SethMWard/ECE-411-Practicum/Group Documents/EagleFiles/Read_Me.txt

T-11 SPTA_V7 Update
Date 11/9/14
Time: 22:44

.SCH
	1) Moved R5.
	4) Changed info box colore.
.LBR
	1) moved power traces.
	2) Increaced power trace width.
