SethMWard/ECE-411-Practicum/Weekly-Status-Reports/Lorenzen-Week#11.md

#Weekly Progress Report
Lorenzen Devin <br>
Week ending: 11-14-2014 <br>

##Last week
----------
  1. creaded Excell BOM
  2. descussed Presintation with group
  3. Presented Project
