SethMWard/ECE-411-Practicum/Weekly-Status-Reports/Lorenzen-Week#10.md

#Weekly Progress Report
Lorenzen Devin <br>
Week ending: 11-7-2014 <br>

##Last week
----------
  1. updated BOM
  2. Updated Packaging
  started Presintation
  
##Tasks for next weak
---------
  1. finish presintation
  2. finish package assembaly
  3. Make a Excell BOM
