SethMWard/ECE-411-Practicum/Weekly-Status-Reports/Lorenzen-Week#8.md

#Weekly Progress Report
Lorenzen Devin <br>
Week ending: 11-23-2014 <br>

##Last week
----------
  1. Meet with group to test SPTA board.
  2. update LED brakout board.
  3. Fab LED brakout board.
  
##Tasks for next weak
---------
  1. assemble final project.
  2. continue testing.
  3. update BOM pricing.
