SethMWard/ECE-411-Practicum/Weekly-Status-Reports/Lorenzen-Week#9.md

#Weekly Progress Report
Lorenzen Devin <br>
Week ending: 11-30-2014 <br>

##Last week
----------
  1. continued testing
  2. updating BOM
  
##Tasks for next weak
---------
 1. finish updating BOM pricing.
 2. finish testing.
 3. work on presintation/demo.
