SethMWard/ECE-411-Practicum/Weekly-Status-Reports/Week7Seth.md

Last Week

Trained on EPL soldering stations

Trained on EPL reflow oven

Next Week

assemble boards
Test and debug assembled board
