SethMWard/ECE-411-Practicum/Weekly-Status-Reports/Week8Seth.md

Last Week:

* Assembled boards
* Tested assembled board
* Updated document links on github wiki

Next Week:

* Design Product case
* Train on laser cutter in the EPL
