SethMWard/ECE-411-Practicum/Weekly-Status-Reports/Week7Jeremiah.md

Last Week
---------------
	Created/Review test plan
	Recreate LED breakout board
	Solder LED breakout board
	
Next Week
---------------
	Meet with group to go over test plan
	Start unit testing board as it goes together
	Assemble final board
	Assemble LED breakout
