SethMWard/ECE-411-Practicum/Weekly-Status-Reports/Week8Jeremiah.md

Last Week
---------------
	Unit testing components - All units passed except for antenna (was able to measure up to 512MHz).
	Soldering for LED breakout board and assembled breakout board.
	EPL training on solder stations, solder template, board creation.
	Cut solder template.
	Cut new LED board.
	
Next Week
---------------
	Put together final boards
	Finish testing of antenna
	Put together cut box for boards
