SethMWard/ECE-411-Practicum/Weekly-Status-Reports/Week9Jeremiah.md

Last Week
---------------
	Unit testing component antenna and components again.
	Soldering for LED breakout board and assembled breakout board.
	EPL training on reflow oven.
	Cut solder template.
	Assemble SPTA board.
	Started looking at box for board - Seth will finish.
	
Next Week
---------------
	Put together final boards
	Finish testing of antenna
	Put together cut box for boards
	Presentation
	Test all boards
	Update all documents
	
Issues
---------------
	Need to find vibration sensor for board
