SethMWard/ECE-411-Practicum/Weekly-Status-Reports/Week9Edward.md

Last Week
---------
      Constructed complete board, excluded buzzer resistor for testing purposes
      Revised code to add RF functionality, all functionality now working
      
Next Week
---------
      Presentation
      Test buzzer with different resistors to try to increase volume
