SethMWard/ECE-411-Practicum/Weekly-Status-Reports/Week8Edward.md

This Week
---------
      Initial testing of board
      Construction of LED board

Next Week
---------
      Write and test code
      Board testing
