SethMWard/ECE-411-Practicum/Weekly-Status-Reports/Lorenzen-Week#6.md

#Weekly Progress Report
Lorenzen Devin <br>
Week ending: 11-16-2014 <br>

##Last week
----------
  1.	Meet with group and discussed project block diagram.
  2.	Updated LED breakout board layout.
  3.		Print LED breakout board.
  4.	Cut solder templet.
  
##Tasks for next weak
---------
  1.	Meet with group discuss testing plan.
  2.	Create test plat.
  3. Solder LED breakout board.
  4. Solder for SPTA board.
