SethMWard/ECE-411-Practicum/Weekly-Status-Reports/Lorenzen-week#7.md

#Weekly Progress Report
Lorenzen Devin <br>
Week ending: 11-16-2014 <br>

##Last week
----------
  1. Meet with group discuss testing plan.
  2. Solder LED breakout board.
  3. Solder for SPTA board.

##Tasks for next weak
---------
  1.	Meet with group to test SPTA board.
  2. update LED brakout board.
  3. cut project packaging.
  4. assemble final project.
  5. start project demo.
