SethMWard/ECE-411-Practicum/Weekly-Status-Reports/Week5Edward.md

Previous Week
-------------
      Assisted with board layout
      Assisted with schematic revisions 
      Wrote first draft and assisted with revision of project schedule
      Met with team to discuss project

Next Week
---------
      Check on parts
      Discuss case
      Start construction if boards recieved early
      EPL training
