SethMWard/ECE-411-Practicum/Weekly-Status-Reports/Week5Seth.md

Last Week

Reviewed microprocessor schematics
Updated parts lists to prep for order
Reviewed schematics as a group and prepared to submit preliminary layout 
with no DRC errors

Next Week

Add BOM wiki page
Request RBP-440+ samples
Train on PCB router/plotter
Update wiki
Work on System Modeling and Design of project
