SethMWard/ECE-411-Practicum/Weekly-Status-Reports/Week6Edward.md

This week
---------
      Contributed to system Modeling / UML State Machine View
      EPL Training for board router

Next week
---------
      Board assembly
      More EPL training
