SethMWard/ECE-411-Practicum/Weekly-Status-Reports/Week6Seth.md

Last Week

Added BOM wiki page
Requested RBP-440+ samples
Trained on PCB router/plotter
Updated wiki homepage
Worked on System Modeling and Design of project

Next Week

Train on EPL soldering stations
Train on EPL reflow oven
assemble boards
Test and debug assembled board
