SethMWard/ECE-411-Practicum/Weekly-Status-Reports/Lorenzen-Week#4.md

#Weekly Progress Report
Lorenzen Devin <br>
Week ending: 11-02-2014 <br>

##Last week
----------
	1.	Meat with group and discussed project needs, task updates, areas of concern.
	2.	Refined schematic layout with Mr. Sayers.
	3.	Updated library files.
	4.	Added SMT-440+ band pass filter to eagle library.
 5.~~Find SMA connector~~(Mr. Ward) <br>
##Tasks for next weak
---------
	1.	Review/update board layout.
	2.	Finalize all library files.
	3.	Confirm part package numbers.
	4.	Release board design for ordering.
