SethMWard/ECE-411-Practicum/Weekly-Status-Reports/Week4Jeremiah.md

Last Week
---------------
	Met with group to review project schematics
  Created schematics for breakout board that includes LEDs and push button switch
  Installed AVR Studio to begin building interrupt handling code for microprocessor
	Trained on EagleCad for schematics and library creation
	
Next Week
---------------
	Meet with group to continue refining schematic
	Create more libraries for LEDs 
  Create schematic for housing unit for the final board
	Take EPL training
	Continue learning to code interrupts for Atmel microprocessor
  Take on the role as Test Planner
	
Issues
---------
	Waiting on parts from Digikey
  Need to meet with Cody/Andrew to better understand the Test Plan
