SethMWard/ECE-411-Practicum/Weekly-Status-Reports/Week4Seth.md

Last Week

Met with group to discuss project schematics
Reviewed data sheets for microprocessor
Updated wiki parts page
Created github directory to contain datasheets
Uploaded datasheets to github
Began assembling needed parts list

Next Week

Determine minimum manufacturing cost
Updated wiki home page
Review microprocessor schematics
Update parts lists to prep for order
Continue compiling  per-unit product cost analysis
Review schematics as a group and prepare to submit preliminary layout 
with no DRC errors
