SethMWard/ECE-411-Practicum/Weekly-Status-Reports/Week3Seth.md

Last Week
-----------------------------------------------------------
1. Met with group to determine project direction
2. Met with group to determine project requirements
3. Met with group to determine project schematics
4. Reviewed data sheets for microprocessor, and RF sensor
5. Updated wiki home page
6. Updated wiki parts list
7. Installed EagleCad
8. Revised Product design specification
	
Next Week
-----------------------------------------------------------
1. Design schematics breakout board for LT5538
2. Update Wiki
	a. Assemble all datasheets into one location
	b. Create page for Product design specification
3. Review microprocessor schematics
4. Start on per-unit product cost analysis
