SethMWard/ECE-411-Practicum/Weekly-Status-Reports/Lorenzen-week#3.md

#Weekly Progress Report
Lorenzen Devin <br>
Week ending 10-26-2014 <br>

##Last week
----------
	1.	Meat with group and discussed requirements, code operation, component selection.
	2.	Develop first draft Project Requirements Document (100%)
	3.	Develop a full schematic (100%)
	4.	Add needed components to eagle cad library (90%)
		a.	Need to find a .25 inch SMA mail connector 
##Tasks for next weak
---------
	1.	Find a .25 inch SMA mail connector
	2.	Finish adding components to eagle’s library
	3.	Develop PCB layout
