SethMWard/ECE-411-Practicum/Weekly-Status-Reports/Week3Edward.md

Last Week
---------
      Met with group to discuss project
      Created a prototype board to simulate stimulus to the ATMEGA328
      Created program for ATMEGA328 and tested it using stimulus from prototype board

Next Week
---------
      Continue refining and testing program
      Training on EPL equipment
