SethMWard/ECE-411-Practicum/Weekly-Status-Reports/Week3Jeremiah.md

Last Week
---------
	Met with group to determine project direction
	Met with group to determine project requirements
	Met with group to determine project schematics
	Reviewed data sheets for microprocessor, and RF sensor
	Ordered SMT packages for microprocessor, voltage regulators
	Ordered dragon board for home testing of microprocessor
	Installed EagleCad
	
Next Week
---------
	Meet with group to continue refining schematic
	Prototype board with RF Chip, voltage regulator, microprocessor and 9v battery
	Take EPL training
	Start coding for interrupt handling and output states
	
Issues
------
	EPL lab being moved soon
	AVR are currently down to one
