SethMWard/ECE-411-Practicum/Group Documents/ECE411 Team 11 Suspicious Package Training Aid.pptx

## Team 11 Suspicious Package Training Aid

Jeremiah Franke
Devin Lorenzen
Edward Sayers
Seth Ward

## Problem Overview

- A request for a training aid from the Oregon Zoo.
- Specific protocols need to be followed in the event of the discovery of an unattended package.
- The unattended package needs to be isolated and unmoved.
- Radio communication cannot be used in proximity of the device.

## Marketing Requirements

Must:
- Be able to detect when a two-way radio is transmitting at a frequency of 410-470 MHz in proximity of the device.
- Be able to detect if the device is moved or agitated.
- Be able to notify the end user if either of the previous two events has occurred.
- Be portable and easily concealed.
- Last the duration of a training period.
Should:
- Notify the user of which event specifically caused a training fault.
May:
- Wireless activation of the device.
- Allow users to modify sensitivity of RF detection.

## Current Market Solutions

- There are several available alternatives on the market
  - These solutions are prohibitively expensive and single purposed
  - None of the solutions offered met the marketing requirements in a single device.

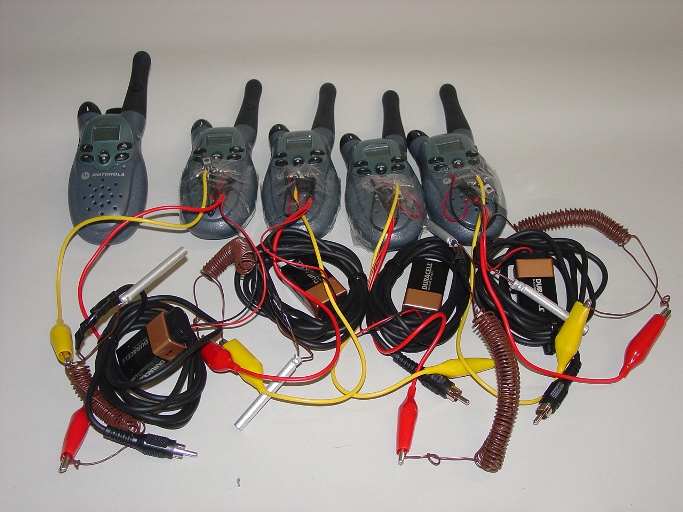
[picture p1: figure]
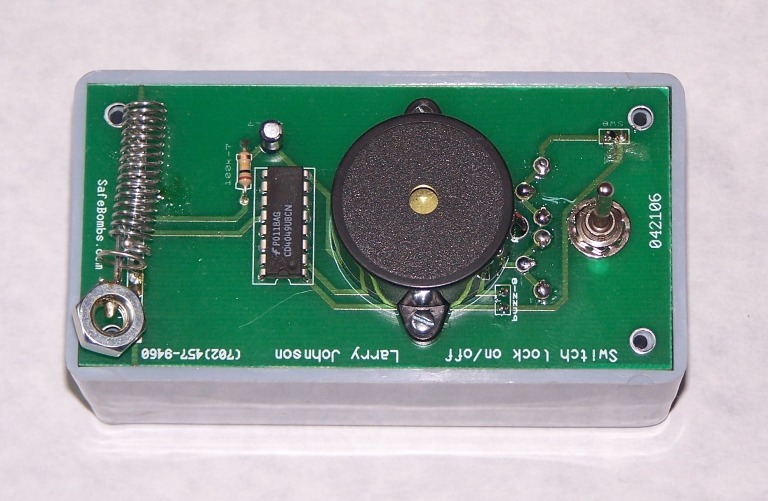
[picture p2: figure]

## Project Implementation

- Vibration sensor
- RF detector
- Auditory and visual indicators
- Microcontroller

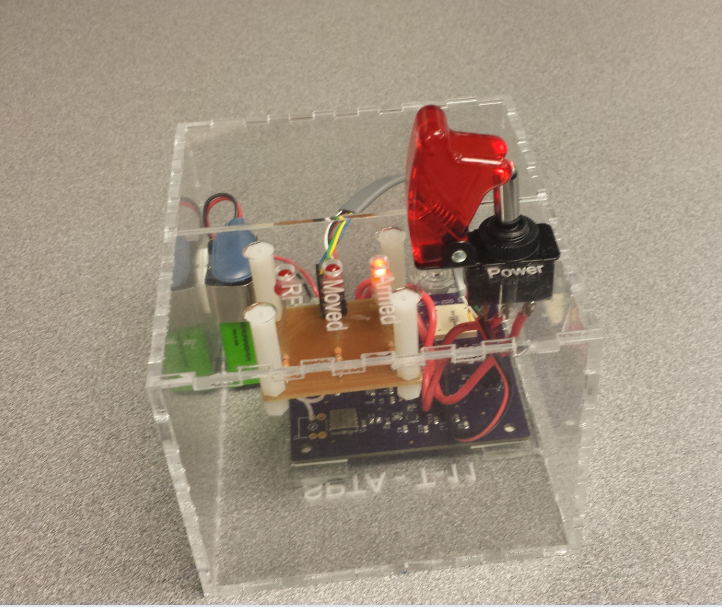
[picture p3: figure]

## Level 1 Block Diagram

## Schematics

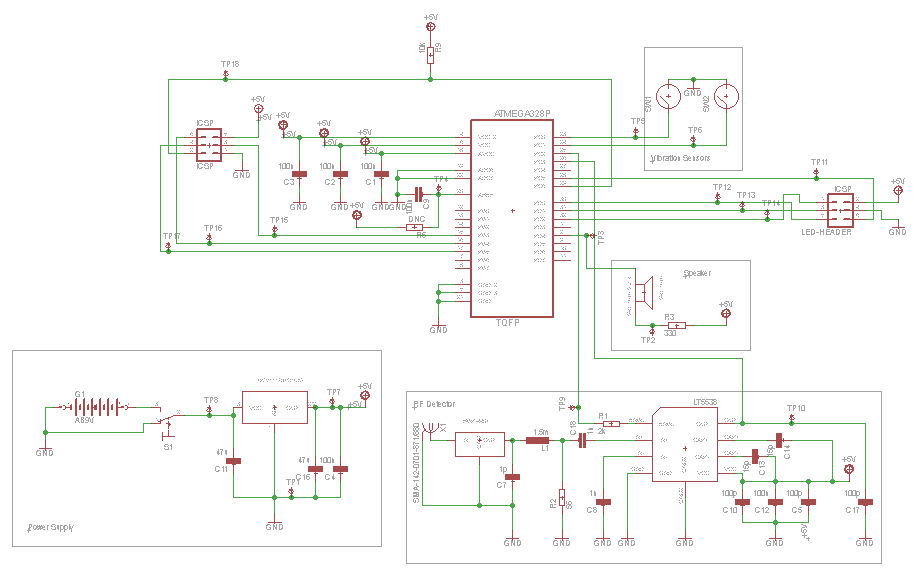
[picture p4: figure]
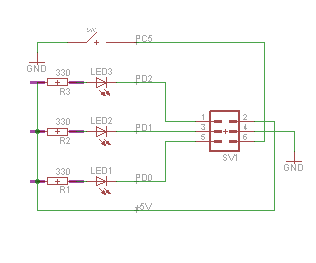
[picture p5: figure]

## Board Layout

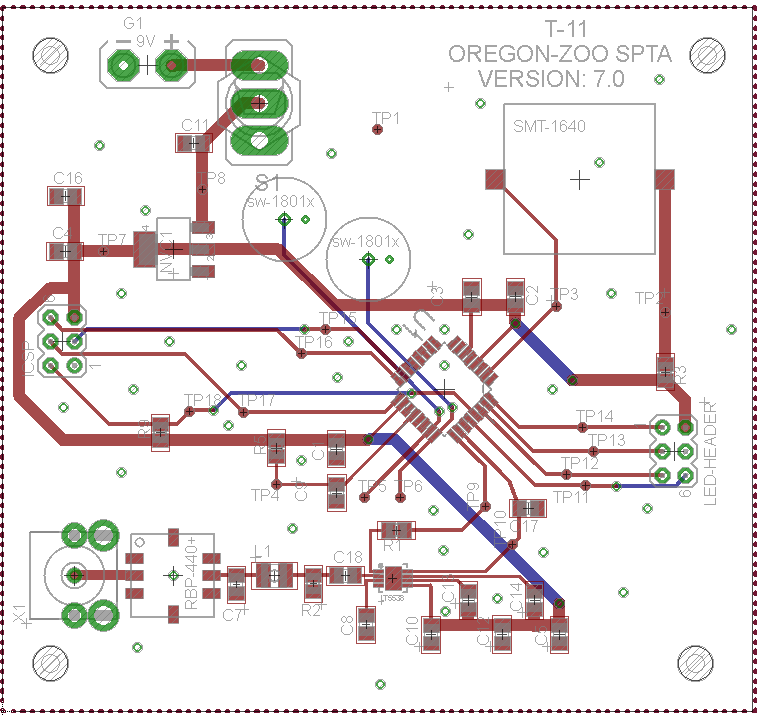
[picture p6: figure]
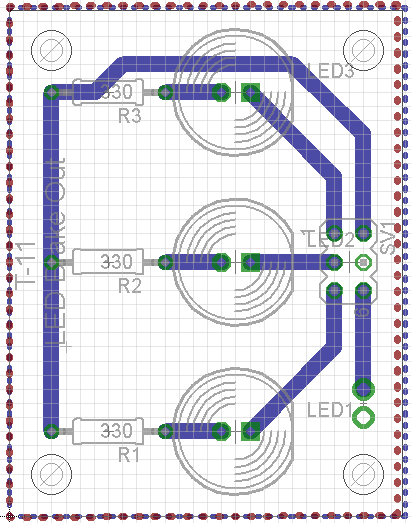
[picture p7: figure]

## Source Code Overview

## Tools Used

- Hardware

- LPKF Board Router
- Reflow Oven
- Laser Cutter
- Soldering Iron
- AVR Dragon

- Software

- Atmel Studio 5
- Eagle Cad
- InkScape

## Testing

- Power Regulation
- RF Detection
- Movement Detection
- LED Indicators
- Power Switch
- Processor
- Buzzer

## Statistics

- 68% surface mount components
- Current draw while armed: 56.5 mA
- Current draw while triggered: 37 mA
- Estimated battery life of 10 hours
- 175 lines of code

## Slide 13

Contributions

Task | Primary contributors
Board Schematic | Devin, Edward
Board Layout | Devin
Code | Edward
Part Acquisition | Jeremiah, Seth
GitHub and Wiki Management | Seth
Documentation | All
Assembly | All
Testing | Jeremiah, Edward

## What we would do differently

Results

- All four boards were fully assembled and function tested
- RF section performed as expected
- Vibration section worked adequately

- Explore other options for the vibration sensor
- Source a louder buzzer
- Remote activation switch
- Opaque and water resistant packaging
- Onboard RF sensitivity calibration
- Source or design a less expensive band pass filter

## Lessons Learned

- How to use the tools in the EPL lab
- Group Project Design
- Teamwork
- Compromise
- Eagle Cad
- Revision Control
