SethMWard/ECE-411-Practicum/Group Documents/Images/Main Schematic.png

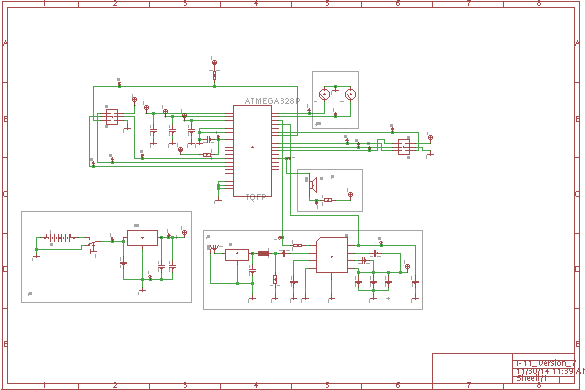
Group Documents/Images/Main Schematic.png
