SethMWard/ECE-411-Practicum/Group Documents/SPTA BOM.xlsx

SPTA Board
QTY | Value | Package | Part | Description | Manufacturer | Model# | Unit Price (US $) | Total (US $) | 1,000 Unit Price (US$)
1 | NA | 320-916 | S1 | Toggle switch | Radio Shack | 275-601 | 5.49 | 5.49 | 5.49
1 | 1.5n | L2825P | L1 | Inductor | Panasonic | ELJ-QF1N5DF | 0.26 | 0.26 | 0.1705
6 | 100n | 0805 | C1, C2, C3, C4, C9, C12 | Capacitor | Kemet | C0805C104k5RACTU | 0.1 | 0.6 | 0.012
3 | 100p | 0805 | C5, C10, C17 | Capacitor | Kemet | C0805C101J5GACTU | 0.1 | 0.3 | 0.0114
1 | 10K | 0805 | R9 | Resistor | Stackpole electronics | RMCF0805FT10K0 | 0.1 | 0.1 | 0.00448
2 | 15p | 0805 | C13, C14 | Capacitor | Samsung | CL21C150JBANNNC | 0.1 | 0.2 | 0.0159
2 | 1n | 0805 | C8, C18 | Capacitor | Kemet | C0805C104K5RACTU | 0.1 | 0.2 | 0.012
1 | 1p | 0805 | C7 | Capacitor | Samsung | CL21C010BBANNNC | 0.1 | 0.1 | 0.00588
1 | 20k | 0805 | R5 | Resistor | Panasonic | ERJ-6ENF2002V | 0.1 | 0.1 | 0.008
1 | 2k | 0805 | R1 | Resistor | Panasonic | ERJ-6ENF2001V | 0.1 | 0.1 | 0.008
1 | 330 | 0805 | R3 | Resistor | Stackpole electronics | RMCF0805JT330R | 0.1 | 0.1 | 0.00448
2 | 47u | 0805 | C11, C16 | Capacitor | TDK | C2012X5R1A476M125AC | 1.03 | 2.06 | 0.369
1 | 56 | 0805 | R2 | Resistor | Stackpole electronics | RMCF0805JT56R0 | 0.1 | 0.1 | 0.0032
1 | NA | AB9V | G1 | Battery Clip | Keystone | 71 | 0.42 | 0.42 | 0.18209
1 | NA | TQFP-32 | U1 | 8-bit Micro Controller | Atmel | ATMEGA328-AUR | 3.51 | 3.51 | 1.75401
2 | NA | MA03-2 | led-Header, SV1 | Pin Header | TE Connectivity | 5-5176264-8 | 0.4 | 0.8 | 0.1893
1 | NA | DFN-DD | LT5538 | RF Power Detector | Linear Technology | LT5538IDD#PBF | 6.4 | 6.4 | 4.5
1 | NA | SOT223 | NVC1 | LDO Voltage Regulator | ON Semiconductor | NCV1117ST50T3G | 0.99 | 0.99 | 0.39848
1 | NA | GP731 | RBP-440+ | Band Pass Filter | Mini Curcuits | RBP-440+ | 15.95 | 15.95 | 13
1 | NA | SMT-1640 | SMT-1640 | Piezo Buzzer | PUI Audio | SMT-1640-S-2-R | 2.5 | 2.5 | 1.3195
1 | NA | SW-1801X | SW1, SW2 | Vibration Sensor | Adafruit | SW18010P | 0.95 | 0.95 | 0.76
1 | NA | NA | NA | Device Package | T-11 | SPTA-PackageV2 | 8 | 8 | 8
1 | NA | NA | SPTA -Board | mother board | T-11 | SPTA-V7 | 15.33 | 15.33 | 11.5
 |  |  |  |  |  |  | Sub Total | 64.56
LED Brake Out Board
QTY | Value | Package | Part | Description | Manufacturer | Model# | Unit Price (US $) | Total (US $) | 1,000 Unit Price (US$)
3 | NA | 10mm | LED1, LED2, LED3 | LED | CREE | C5SMF-RJS-CT0W0BB2 | 0.21 | 0.63 | 0.136
3 | 330 | 0207/10 | R1, R2, R3 | Resistor | Stackpole electronics | CF14JT330R | 0.1 | 0.3 | 0.008
1 | NA | MA03-2 | Led-Header | Pin Header | TE Connectivity | 5-5176264-8 | 0.4 | 0.4 | 0.1893
1 | NA | LEDBOB | Board | LED Breakout Board | T-11 | LEDBOB-V8 | 5 | 5 | 30
 |  |  |  |  |  |  | Sub Total | 6.33
 |  |  |  |  |  |  | Total | 70.89
