SethMWard/ECE-411-Practicum/Group Documents/Integration test RF&CPU.docx

Test Writer: Jeremiah Franke
Test Case Name: | | | | | RF CPU Integration Test | | | | | Test ID#: | | RFCPU-I-1
Description: | | | | | Test that the output of the ATMEGA 328 when integrated with the LT5538 RF chip on its ADC is a high signal only when the RF chip is supplied with a 410 to 510Mhz radio signal. | | | | | Type: | | ☒ Black Box ☐ White Box

Tester Information:
Name of Tester: | | | | | | | | Date:
Hardware Ver: | | | 1.0 | | | | | Time:
Setup: | | | | | | | | Have a frequency generator. Make sure to have power going to the RF chip and ATMEGA 328. Have a capacitor between the power source and RF chip and ATMEGA. Have a voltmeter for measuring output of the ATMEGA. Ground the RF chip, ATMEGA, and power source as appropriate. Wire the RF chip to the ADC input port of the ATMEGA 328.
Step | Action | Expected Result | | Pass | | Fail | N/A | | Comments
1 | Compile RFTest.c in /working direcory | No warning generated by IDE.
2 | Download compiled file. | File downloaded successfully.
3 | Run the downloaded file. | No smoke.
4 | Hook 410Mhz output from frequency generator to frequency input on RF chip. | High signal greater than .8v is read from output pin 7 of the ATMEGA.
5 | Change frequency generator to 420Mhz. | High signal greater than .8v is read from output pin 7 of the ATMEGA.
6 | Change frequency generator to 440Mhz. | High signal greater than .8v is read from output pin 7 of the ATMEGA.
7 | Change frequency generator to 460Mhz. | High signal greater than .8v is read from output pin 7 of the ATMEGA.
8 | Change frequency generator to 480Mhz. | High signal greater than .8v is read from output pin 7 of the ATMEGA.
9 | Change frequency generator to 500Mhz. | High signal greater than .8v is read from output pin 7 of the ATMEGA.
10 | Change frequency generator to 510Mhz. | High signal greater than .8v is read from output pin 7 of the ATMEGA.
11 | Change frequency generator to 530Mhz. | Low signal less than .8v is read from output pin 7 of the ATMEGA.
12 | Change frequency generator to 390Mhz. | Low signal less than .8v is read from output pin 7 of the ATMEGA.
Overall test results:
