SethMWard/ECE-411-Practicum/Group Documents/EagleFiles/LED Breakout Board V8.brd

## EAGLE design Group Documents/EagleFiles/LED Breakout Board V8.brd (2014-12-12)

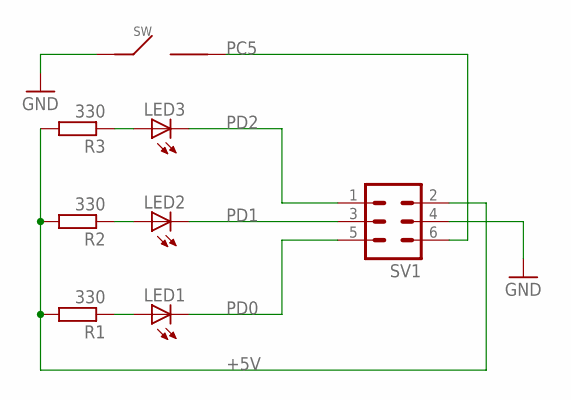
[picture p9: schematic LED Breakout Board V8.sch]

Parts:
LED1, LED2, LED3: LED10MM
R1, R2, R3: 330; 0207/10
SV1: MA03-2
SW: PUSHBUTTON

Connections:
+5V: R1.2, R2.2, R3.2, SV1.2
GND: SV1.4, SW.IN
unnamed: LED3.A, R3.1
unnamed: LED2.A, R2.1
unnamed: LED1.A, R1.1
PC5: SV1.6, SW.OUT
PD0: LED1.K (C), SV1.5
PD1: LED2.K (C), SV1.3
PD2: LED3.K (C), SV1.1

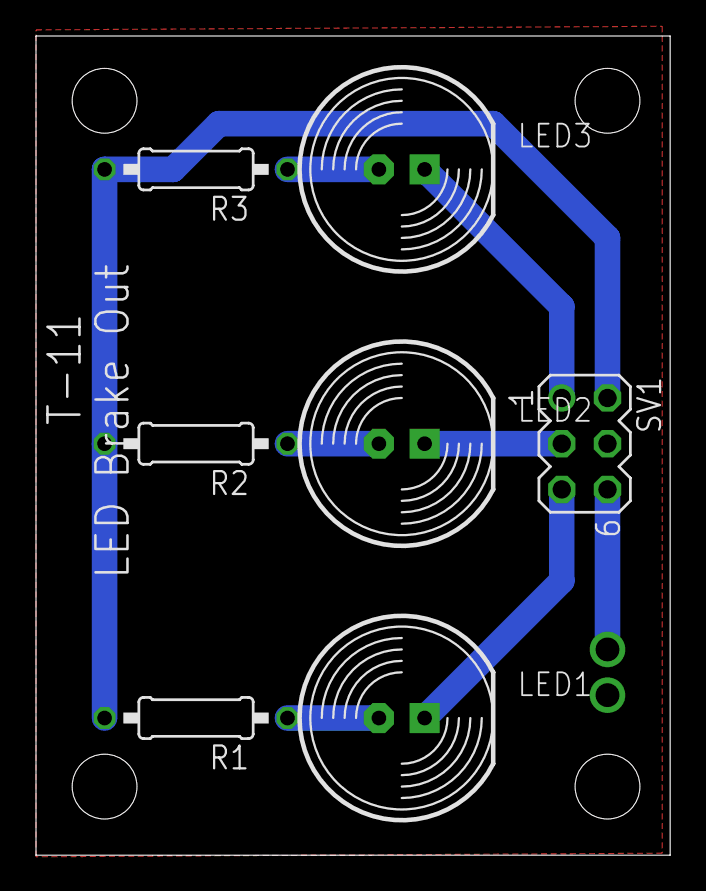
[picture p10: board LED Breakout Board V8.brd from above]

Board: 2 copper layers, 35.2 x 45.5 mm, 8 parts (0 on the bottom side), 9 nets.
