SethMWard/ECE-411-Practicum/Group Documents/EagleFiles/T-11_Version_7.brd

## EAGLE design Group Documents/EagleFiles/T-11_Version_7.brd (2014-11-30)

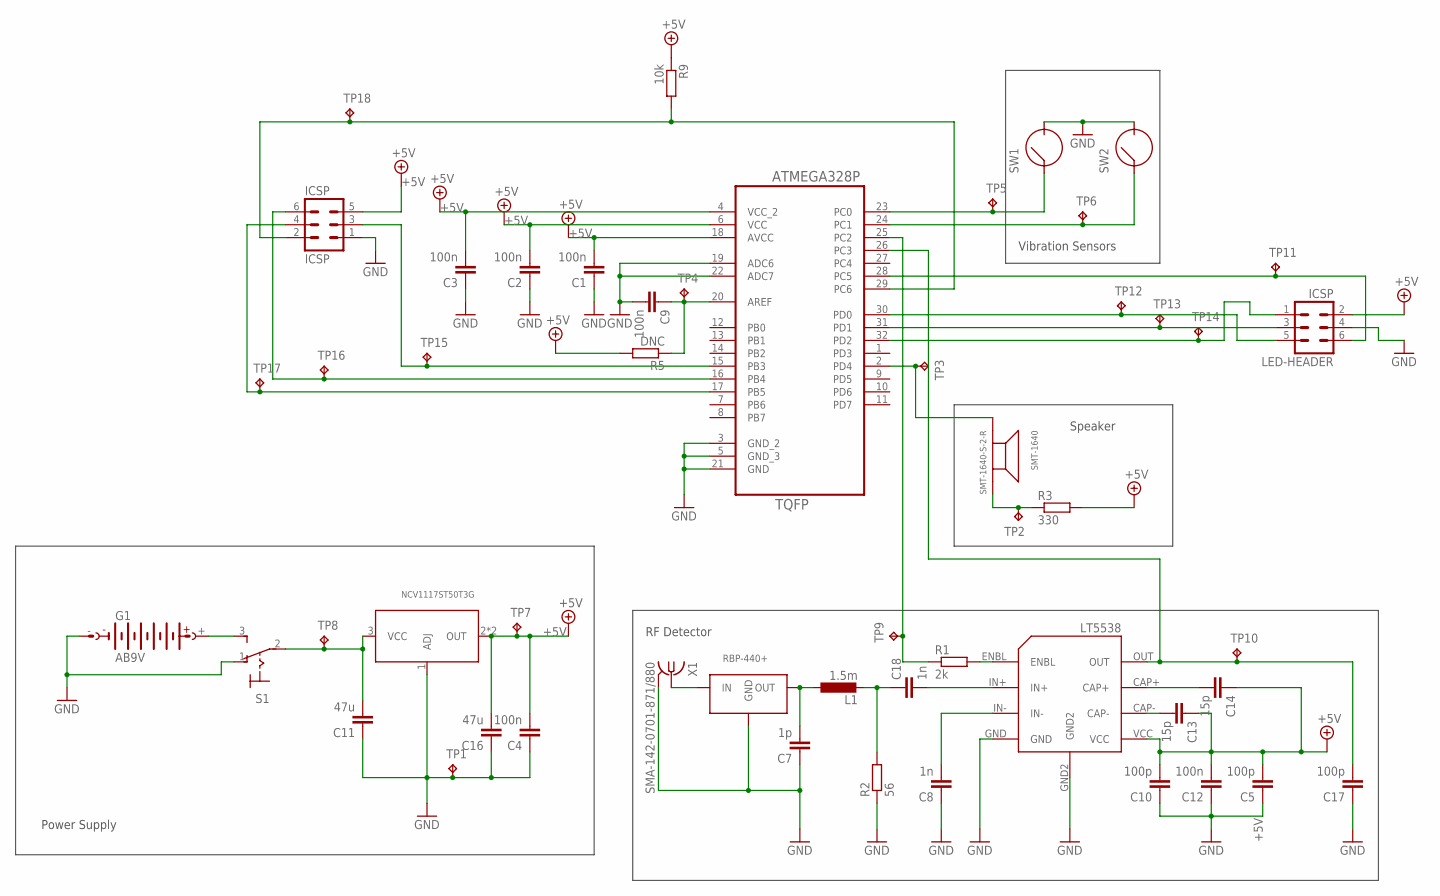
[picture p11: schematic T-11_Version_7.sch]

Parts:
C1, C2, C3, C4, C9, C12: 100n; C0805
C5, C10, C17: 100p; C0805
C7: 1p; C0805
C8, C18: 1n; C0805
C11, C16: 47u; C0805
C13, C14: 15p; C0805
G1: AB9V
ICSP: ICSP; MA03-2
L1: 1.5m; L2825P
LED-HEADER: ICSP; MA03-2
LT5538: LT5538
NVC1: NCV1117ST50T3G; SOT223
R1: 2k; R0805
R2: 56; R0805
R3: 330; R0805
R5: DNC; R0805
R9: 10k; R0805
RBP-440+: RBP-440+; GP731
S1: 320-916
SMT-1640: SMT-1640-S-2-R; SMT-1640
SW1, SW2: SW-1801X
TP1, TP2, TP3, TP4, TP5, TP6, TP7, TP8, TP9, TP10, TP11, TP12, TP13, TP14, TP15, TP16, TP17, TP18: TPTP10R; TP10R
U1: ATMEGA328P-AU; QFP80P900X900X120-32N
X1: SMA-142-0701-871/880; SMA-142-0701-871

Connections:
+5V: C1.2, C2.2, C3.2, C4.2, C5.2, C10.2, C12.2, C13.1, C14.1, C16.2, ICSP.5, LED-HEADER.2, LT5538.VCC, NVC1.2 (OUT), NVC1.4 (OUT), R3.2, R5.2, R9.1, TP7.TP, U1.4 (VCC_2), U1.6 (VCC), U1.18 (AVCC)
ANT_IN_1: C7.2, L1.1, RBP-440+.6 (OUT)
ANT_IN_2: C18.1, L1.2, R2.2
GND: C1.1, C2.1, C3.1, C4.1, C5.1, C7.1, C8.1, C9.2, C10.1, C11.1, C12.1, C16.1, C17.1, G1.-, ICSP.1, LED-HEADER.4, LT5538.GND, LT5538.GND2, NVC1.1 (ADJ), R2.1, RBP-440+.1 (GND), RBP-440+.3 (GND), RBP-440+.4 (GND), RBP-440+.5 (GND), RBP-440+.7 (GND), RBP-440+.8 (GND), S1.1 (O), SW1.P$2, SW2.P$2, TP1.TP, U1.3 (GND_2), U1.5 (GND_3), U1.19 (ADC6), U1.21 (GND), U1.22 (ADC7), X1.2@1 (2), X1.2@2 (2), X1.2@3 (2), X1.2@4 (2)
INDICATOR_1: LED-HEADER.1, TP14.TP, U1.32 (PD2)
INDICATOR_2: LED-HEADER.3, TP13.TP, U1.31 (PD1)
INDICATOR_3: LED-HEADER.5, TP12.TP, U1.30 (PD0)
MISO: ICSP.6, TP16.TP, U1.16 (PB4)
MOSI: ICSP.3, TP15.TP, U1.15 (PB3)
unnamed: LED-HEADER.6, TP11.TP, U1.28 (PC5)
unnamed: RBP-440+.2 (IN), X1.1
unnamed: R3.1, SMT-1640.P$1 (OUT), TP2.TP
unnamed: G1.+, S1.3 (S)
unnamed: C18.2, LT5538.IN+
unnamed: LT5538.ENBL, R1.2
unnamed: C14.2, LT5538.CAP+
unnamed: C13.2, LT5538.CAP-
unnamed: C9.1, R5.1, TP4.TP, U1.20 (AREF)
unnamed: SMT-1640.P$2 (IN), TP3.TP, U1.2 (PD4)
PS_VIN: C11.2, NVC1.3 (VCC), S1.2, TP8.TP
RESET: ICSP.2, R9.2, TP18.TP, U1.29 (PC6)
RF_ENABLE: R1.1, TP9.TP, U1.25 (PC2)
RF_IN-: C8.2, LT5538.IN-
RF_OUT: C17.2, LT5538.OUT, TP10.TP, U1.26 (PC3)
SCK: ICSP.4, TP17.TP, U1.17 (PB5)
VIB_1: SW2.P$1, TP6.TP, U1.24 (PC1)
VIB_2: SW1.P$1, TP5.TP, U1.23 (PC0)

Notes on the sheet:
Power Supply
RF Detector
Speaker
Vibration Sensors

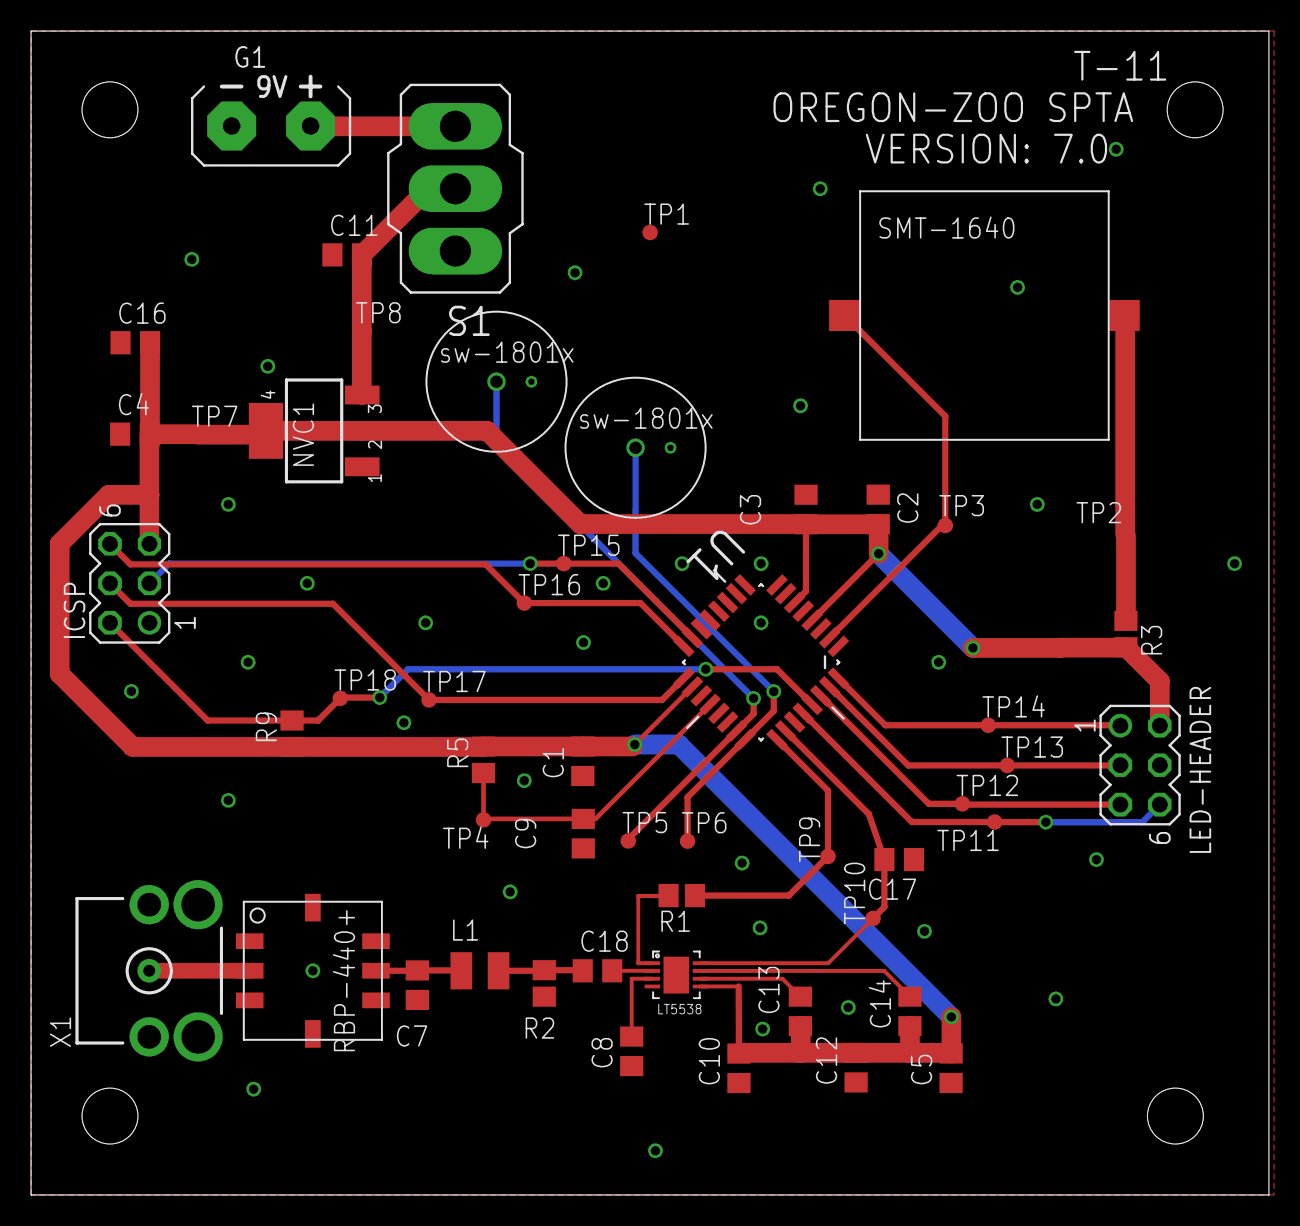
[picture p12: board T-11_Version_7.brd from above]

Board: 2 copper layers, 79.7 x 74.9 mm, 52 parts (0 on the bottom side), 27 nets.
