SethMWard/ECE-411-Practicum/(commit log)

2014-10-13 Add Draft of decision matrix
    Draft of decision matrix
    [Decision Matrix Draft.xlsx]
2014-10-13 Format Update
    Changed formatting to be more presentable.
    [Decision Matrix Draft.xlsx]
2014-10-13 Spelling Fixes
    [Decision Matrix Draft.xlsx]
2014-10-13 Moved
    Moved into new directory
    [Project Decision Matrix.xlsx]
2014-10-13 Updated Preferences
    [Project Decision Matrix.xlsx]
2014-10-13 Actually updated rankings
    [Project Decision Matrix.xlsx]
2014-10-23 CAD Libraries
    Added CAD Libraries For sw-180xx, atmega, 328p-AU, LT5538
2014-10-24 LT5538 test board v1
    Added a test board for the LT5538
2014-10-27 T-11 Schematic. V1.00
    Added Eagle schematic.
    [T-11_Version.1.00.sch]
2014-10-27 Project Design Specifications updated
    I updated the motion sensor portion of the document and changed some of
    the autocorrect silliness that finds its way into the documents. Had to
    change the extension because I do not have word on my home computer.
2014-10-29 Rename T-11_Version_1_00.sch to T-11_Version.1.00.sch
    Not sure why I initially changed the name
    [T-11_Version.1.00.sch]
2014-10-30 Updated schematic to 1.1
    Added ICSP header
    Resolved ERC problems
    Removed crystal
    Changed power switch and added 9V clip
    [T-11_Version_1_1.sch]
2014-11-01 Schematic Version 1.2
    [T-11_Version_1_2.sch]
2014-11-04 Added bandpass filter datasheet
2014-11-04 Update
    Updated and added library files.
    Updated schematic.
    [T-11_Version_1_3.sch]
2014-11-05 Added eagle files and LED breakout board
    [LED Breakout Board.sch]
2014-11-05 T-11 SCH&BRD
    Updated schematic
    Added PCB layout.
2014-11-05 LED Brake out BRD V2
    Changed LED PKG
    Changed header pins outs
    Added GPIO pin labels to nets
    Added PCB BRD
2014-11-05 SCH&BRD files
    Added PCB layout bdr file
    Added part name to LT5538
    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
2014-11-05 SCH@BRD files
    added a GND via under the ATMEGA382-AU
2014-11-05 SCH&BDR Update
    updated schematic and board to version 5 (view Read_Me)
2014-11-05 LED Brakeout Update
    sch
    Added frame to sch file.
    brd
    Added product name to brd file.
    Increased board size.
    Added 3.6mm mounting holes.
2014-11-05 Updated schematic to resolve ERC issues
    Updated package to resolve wrong pin type
    Added values to C13 and C14
    Resolved overlapping pins
    Moved overlapping test points
    [T-11_Version_5.brd, T-11_Version_5.sch]
2014-11-08 BOM
    Added BOM
2014-11-08 T-11 SPTA_V6-update
    Updated Read_me
    updated schematic
    updated board layout
    Updated BOM
    [T-11_Version_5.sch, T-11_Version_6.brd, T-11_Version_6.sch]
2014-11-08 LED-Brake-out-V4
    moved mounting holes
    changed resistor PKG size.
    added BOM
2014-11-09 Added board and schematic image files
2014-11-09 Added schematic image files Rev 6
2014-11-10 layout 7
    updated schematic.
    updated SPTA layout.
    updated LED brake-out layout.
    [T-11_Version_7.brd, T-11_Version_7.sch]
2014-11-30 Consolidated Documents
    [LED Breakout Board.sch, T-11_Version.1.00.sch, T-11_Version_1_1.sch, T-11_Version_1_2.sch, T-11_Version_1_3.sch]
2014-11-30 LED V7
    Changed LED to 10mm
    Removed R2, R3.
    Moved traces to bottom layer
    [LED Breakout Board V6.brd, LED Breakout Board V6.sch]
2014-11-30 LED V7
    changed 330 ohm PKG
    changed switch to ground
    [LED Breakout Board V6.brd, LED Breakout Board V6.sch, LED Breakout Board V7.brd, LED Breakout Board V7.sch]
2014-12-07 SPTA Case
2014-12-12 LED BOB
    [LED Breakout Board V8.brd, LED Breakout Board V8.sch]
2014-12-12 SPTA BOM
    [SPTA BOM.xlsx]
2014-12-12 Added Schematic Image
